adamhrnciar/hyperion-controller/fab/pcbway/hyperion-v1.2-bottom-render.png

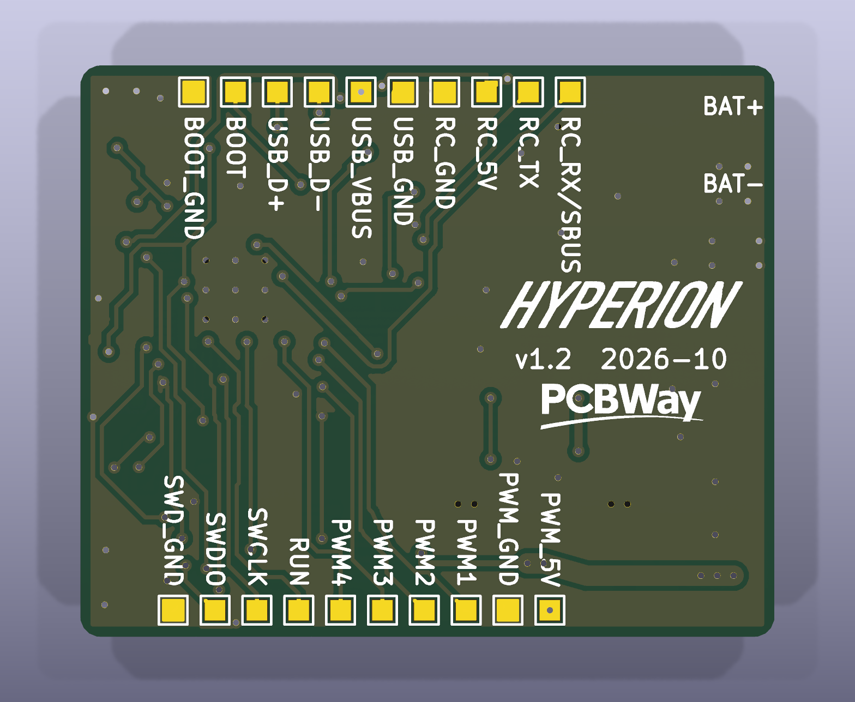
fab/pcbway/hyperion-v1.2-bottom-render.png
