adamhrnciar/hyperion-controller/images/preview_bottom.png

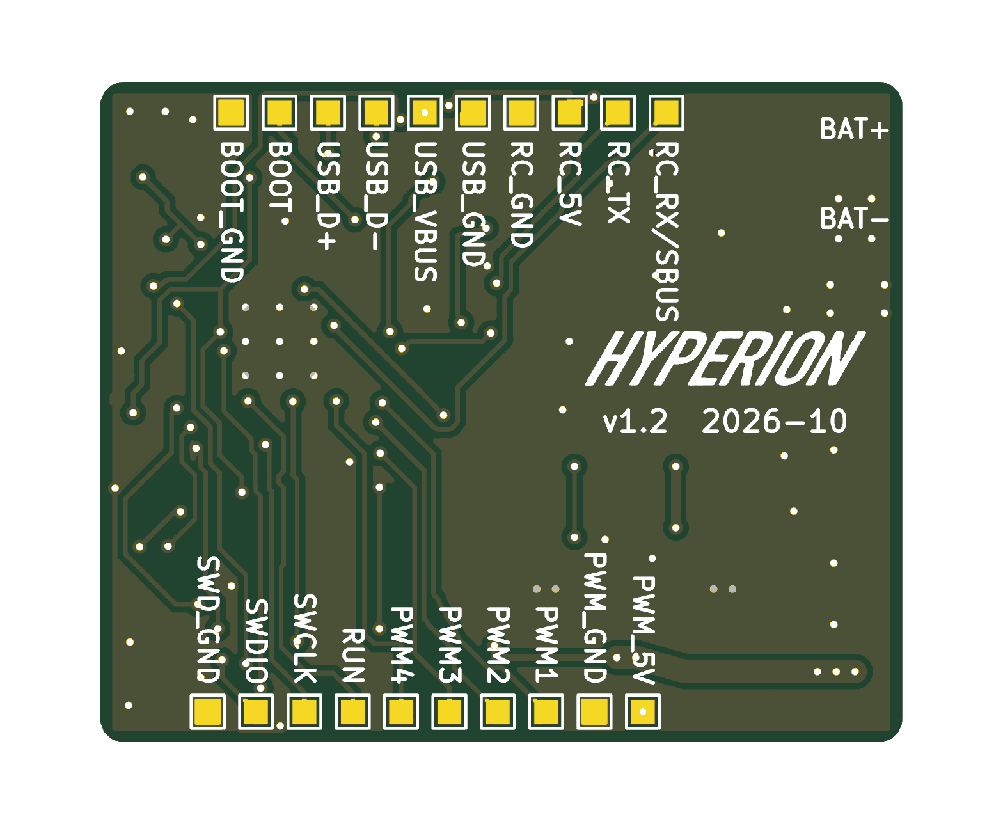
images/preview_bottom.png
