adamhrnciar/hyperion-controller/images/preview_top.png

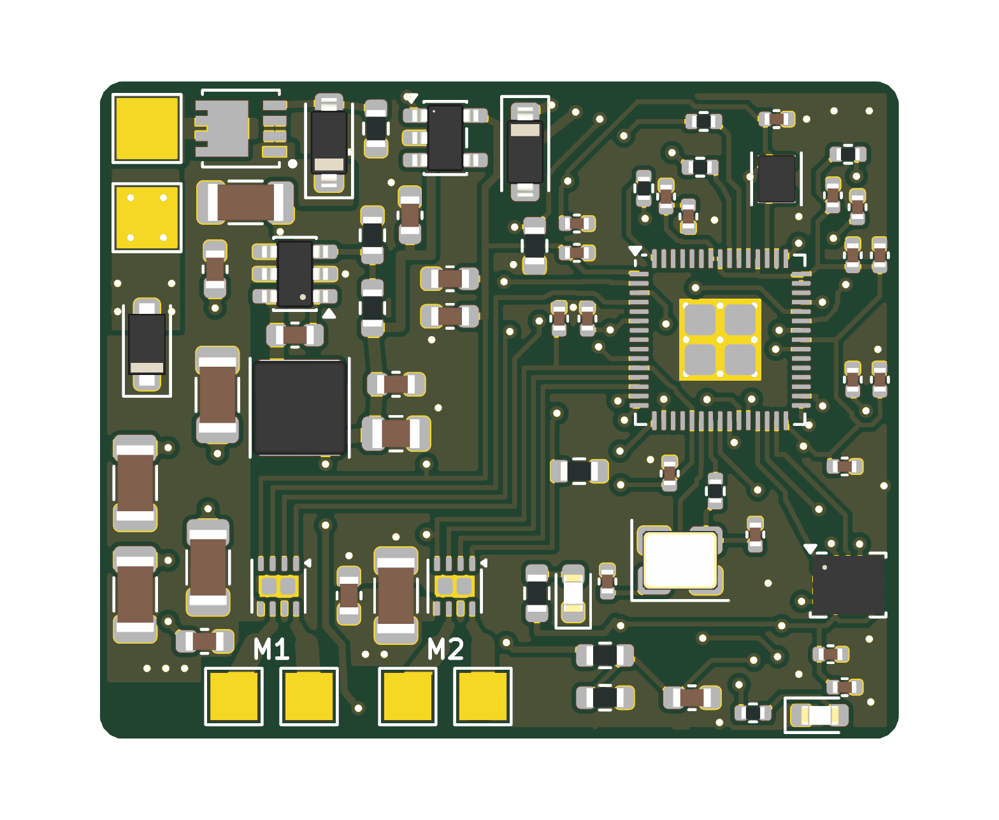
images/preview_top.png
