adamhrnciar/hyperion-controller/fab/review-2026-11-13/schematic-bom.csv

Reference | Value | Footprint | LCSC | MPN | Manufacturer | DNP | EXCLUDE_FROM_BOARD | EXCLUDE_FROM_BOM
C1 | 10uF 50V X7R | Capacitor_SMD:C_1206_3216Metric | C89632 | CL31B106KBHNNNE
C2 | 10uF 50V X7R | Capacitor_SMD:C_1206_3216Metric | C89632 | CL31B106KBHNNNE
C3 | 100uF 35V elec DNP (wire to pads) | Capacitor_SMD:C_1206_3216Metric | C2836437 | RVE100UF35V67RV0072 (optional, hand-wired)
C4 | 4.7uF 50V X7R | Capacitor_SMD:C_1206_3216Metric | C7472974 | HGC1206R7475K500NSPJ
C5 | 100nF 50V | Capacitor_SMD:C_0603_1608Metric | C286510 | 0603B104M500NT
C6 | 100nF 50V | Capacitor_SMD:C_0603_1608Metric | C286510 | 0603B104M500NT
C7 | 22uF 10V | Capacitor_SMD:C_0805_2012Metric | C29277 | CL21A226MPQNNNE
C8 | 100nF 50V | Capacitor_SMD:C_0603_1608Metric | C286510 | 0603B104M500NT
C9 | 10uF 10V | Capacitor_SMD:C_0603_1608Metric | C19702 | CL10A106KP8NNNC
C10 | 1uF 16V | Capacitor_SMD:C_0603_1608Metric | C696901 | TCC0603X5R105K160CT
C11 | 1uF 16V | Capacitor_SMD:C_0603_1608Metric | C696901 | TCC0603X5R105K160CT
C12 | 4.7uF 16V | Capacitor_SMD:C_0603_1608Metric | C19666 | CL10A475KO8NNNC
C13 | 100nF | Capacitor_SMD:C_0402_1005Metric | C1525 | CL05B104KO5NNNC
C14 | 100nF | Capacitor_SMD:C_0402_1005Metric | C1525 | CL05B104KO5NNNC
C15 | 100nF | Capacitor_SMD:C_0402_1005Metric | C1525 | CL05B104KO5NNNC
C16 | 100nF | Capacitor_SMD:C_0402_1005Metric | C1525 | CL05B104KO5NNNC
C17 | 100nF | Capacitor_SMD:C_0402_1005Metric | C1525 | CL05B104KO5NNNC
C18 | 100nF | Capacitor_SMD:C_0402_1005Metric | C1525 | CL05B104KO5NNNC
C19 | 100nF | Capacitor_SMD:C_0402_1005Metric | C1525 | CL05B104KO5NNNC
C20 | 100nF | Capacitor_SMD:C_0402_1005Metric | C1525 | CL05B104KO5NNNC
C21 | 100nF | Capacitor_SMD:C_0402_1005Metric | C1525 | CL05B104KO5NNNC
C22 | 4.7uF 10V | Capacitor_SMD:C_0402_1005Metric | C23733 | CL05A475MP5NRNC
C23 | 4.7uF 10V | Capacitor_SMD:C_0402_1005Metric | C23733 | CL05A475MP5NRNC
C24 | 4.7uF 10V | Capacitor_SMD:C_0402_1005Metric | C23733 | CL05A475MP5NRNC
C25 | 100nF | Capacitor_SMD:C_0402_1005Metric | C1525 | CL05B104KO5NNNC
C26 | 100nF | Capacitor_SMD:C_0402_1005Metric | C1525 | CL05B104KO5NNNC
C27 | 100nF | Capacitor_SMD:C_0402_1005Metric | C1525 | CL05B104KO5NNNC
C28 | 15pF | Capacitor_SMD:C_0402_1005Metric | C1548 | 0402CG150J500NT
C29 | 15pF | Capacitor_SMD:C_0402_1005Metric | C1548 | 0402CG150J500NT
C30 | 100nF 50V | Capacitor_SMD:C_0603_1608Metric | C286510 | 0603B104M500NT
C31 | 10uF 50V X7R | Capacitor_SMD:C_1206_3216Metric | C89632 | CL31B106KBHNNNE
C32 | 100nF 50V | Capacitor_SMD:C_0603_1608Metric | C286510 | 0603B104M500NT
C33 | 10uF 50V X7R | Capacitor_SMD:C_1206_3216Metric | C89632 | CL31B106KBHNNNE
C34 | 100nF | Capacitor_SMD:C_0402_1005Metric | C1525 | CL05B104KO5NNNC
C35 | 100nF | Capacitor_SMD:C_0402_1005Metric | C1525 | CL05B104KO5NNNC
D1 | SMF18A | Diode_SMD:D_SOD-123F | C1509591 | SMF18A (JSCJ)
D2 | BZT52C12 | Diode_SMD:D_SOD-123 | C173429 | BZT52C12 (MDD)
D3 | B5819W | Diode_SMD:D_SOD-123 | C64885 | B5819W (MDD)
D4 | Red | LED_SMD:LED_0603_1608Metric | C2286 | KT-0603R
D5 | Green | LED_SMD:LED_0603_1608Metric | C7496818 | P2-0603G1TS2-06T-002
L1 | 3.3uH AOTA-B201610S3R3-101-T | Inductor_SMD:L_Murata_DFE201610P | C42411119 | AOTA-B201610S3R3-101-T
L2 | 10uH FNR4030S100MT | Inductor_SMD:L_Changjiang_FNR4030S | C167879 | FNR4030S100MT
Q1 | AON7403 | hyperion:AON7403_PowerPAK1212-8_GSD | C5310961 | AON7403 (TECH PUBLIC)
R1 | 47k | Resistor_SMD:R_0603_1608Metric | C25819 | 0603WAF4702T5E
R2 | 115k 1% | Resistor_SMD:R_0603_1608Metric | C22783 | 0603WAF1153T5E
R3 | 22k 1% | Resistor_SMD:R_0603_1608Metric | C31850 | 0603WAF2202T5E
R4 | 100k | Resistor_SMD:R_0603_1608Metric | C25803 | 0603WAF1003T5E
R5 | 22k | Resistor_SMD:R_0603_1608Metric | C31850 | 0603WAF2202T5E
R6 | 1k | Resistor_SMD:R_0603_1608Metric | C21190 | 0603WAF1001T5E
R7 | 33R | Resistor_SMD:R_0402_1005Metric | C25105 | 0402WGF330JTCE
R8 | 1k | Resistor_SMD:R_0402_1005Metric | C11702 | 0402WGF1001TCE
R9 | 27R | Resistor_SMD:R_0402_1005Metric | C140174 | RC-02K27R0FT
R10 | 27R | Resistor_SMD:R_0402_1005Metric | C140174 | RC-02K27R0FT
R11 | 1k | Resistor_SMD:R_0402_1005Metric | C11702 | 0402WGF1001TCE
R12 | 1k | Resistor_SMD:R_0402_1005Metric | C11702 | 0402WGF1001TCE
R13 | 1.5k 1% | Resistor_SMD:R_0603_1608Metric | C22843 | 0603WAF1501T5E
R14 | 1.5k 1% | Resistor_SMD:R_0603_1608Metric | C22843 | 0603WAF1501T5E
TP1 | BAT+ | TestPoint:TestPoint_Pad_2.5x2.5mm
TP2 | BAT- | TestPoint:TestPoint_Pad_2.5x2.5mm
TP3 | USB_VBUS | TestPoint:TestPoint_Pad_1.0x1.0mm
TP4 | USB_D+ | TestPoint:TestPoint_Pad_1.0x1.0mm
TP5 | USB_D- | TestPoint:TestPoint_Pad_1.0x1.0mm
TP6 | USB_GND | TestPoint:TestPoint_Pad_1.0x1.0mm
TP7 | RUN | TestPoint:TestPoint_Pad_1.0x1.0mm
TP8 | SWCLK | TestPoint:TestPoint_Pad_1.0x1.0mm
TP9 | SWDIO | TestPoint:TestPoint_Pad_1.0x1.0mm
TP10 | SWD_GND | TestPoint:TestPoint_Pad_1.0x1.0mm
TP11 | BOOT | TestPoint:TestPoint_Pad_1.0x1.0mm
TP12 | BOOT_GND | TestPoint:TestPoint_Pad_1.0x1.0mm
TP13 | M1A | TestPoint:TestPoint_Pad_2.0x2.0mm
TP14 | M1B | TestPoint:TestPoint_Pad_2.0x2.0mm
TP15 | M2A | TestPoint:TestPoint_Pad_2.0x2.0mm
TP16 | M2B | TestPoint:TestPoint_Pad_2.0x2.0mm
TP17 | RC_5V | TestPoint:TestPoint_Pad_1.0x1.0mm
TP18 | RC_GND | TestPoint:TestPoint_Pad_1.0x1.0mm
TP19 | RC_TX | TestPoint:TestPoint_Pad_1.0x1.0mm
TP20 | RC_RX/SBUS | TestPoint:TestPoint_Pad_1.0x1.0mm
TP21 | PWM1 | TestPoint:TestPoint_Pad_1.0x1.0mm
TP22 | PWM2 | TestPoint:TestPoint_Pad_1.0x1.0mm
TP23 | PWM3 | TestPoint:TestPoint_Pad_1.0x1.0mm
TP24 | PWM4 | TestPoint:TestPoint_Pad_1.0x1.0mm
TP25 | PWM_5V | TestPoint:TestPoint_Pad_1.0x1.0mm
TP26 | PWM_GND | TestPoint:TestPoint_Pad_1.0x1.0mm
U1 | RP2354A | hyperion:RP2354A_QFN-60_CircuitNinja | C41378174 | RP2354A
U2 | DRV8231ADSGR | Package_SON:Texas_DSG0008A_WSON-8-1EP_2x2mm_P0.5mm_EP0.9x1.6mm | C5139865 | DRV8231ADSGR
U3 | DRV8231ADSGR | Package_SON:Texas_DSG0008A_WSON-8-1EP_2x2mm_P0.5mm_EP0.9x1.6mm | C5139865 | DRV8231ADSGR
U4 | LMR51610YDBVR | Package_TO_SOT_SMD:SOT-23-6 | C22427220 | LMR51610YDBVR
U5 | ME6211C33M5G | Package_TO_SOT_SMD:SOT-23-5 | C82942 | ME6211C33M5G-N
U6 | LSM6DSV32XTR | hyperion:LGA-14_3x2.5mm_P0.5mm_CircuitNinja | C22461202 | LSM6DSV32XTR
Y1 | 12MHz ABM8-272-T3 | Crystal:Crystal_SMD_3225-4Pin_3.2x2.5mm | C20625731 | ABM8-272-T3
