adamhrnciar/hyperion-controller/docs/hyperion-v1.2-schematic.pdf

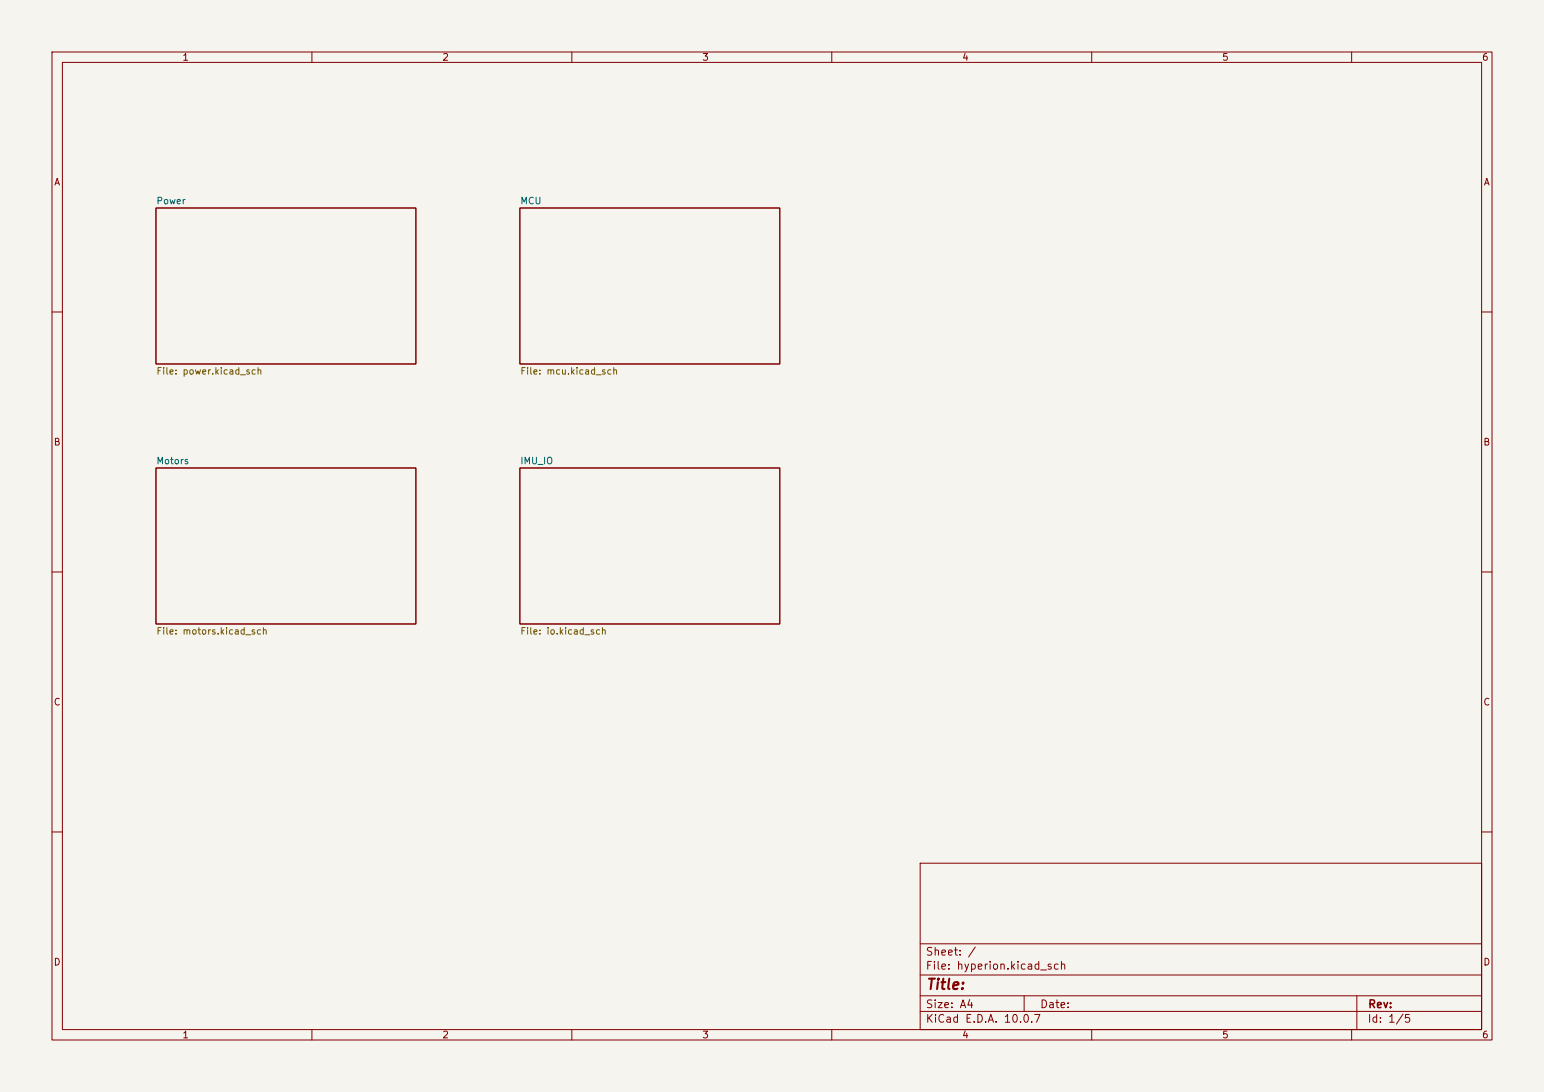
[picture p6: page 1]

File: mcu.kicad_sch Motors File: motors.kicad_sch

Size: A4 | Rev:
KiCad E.D.A. 10.0.7 | Id: 1/5

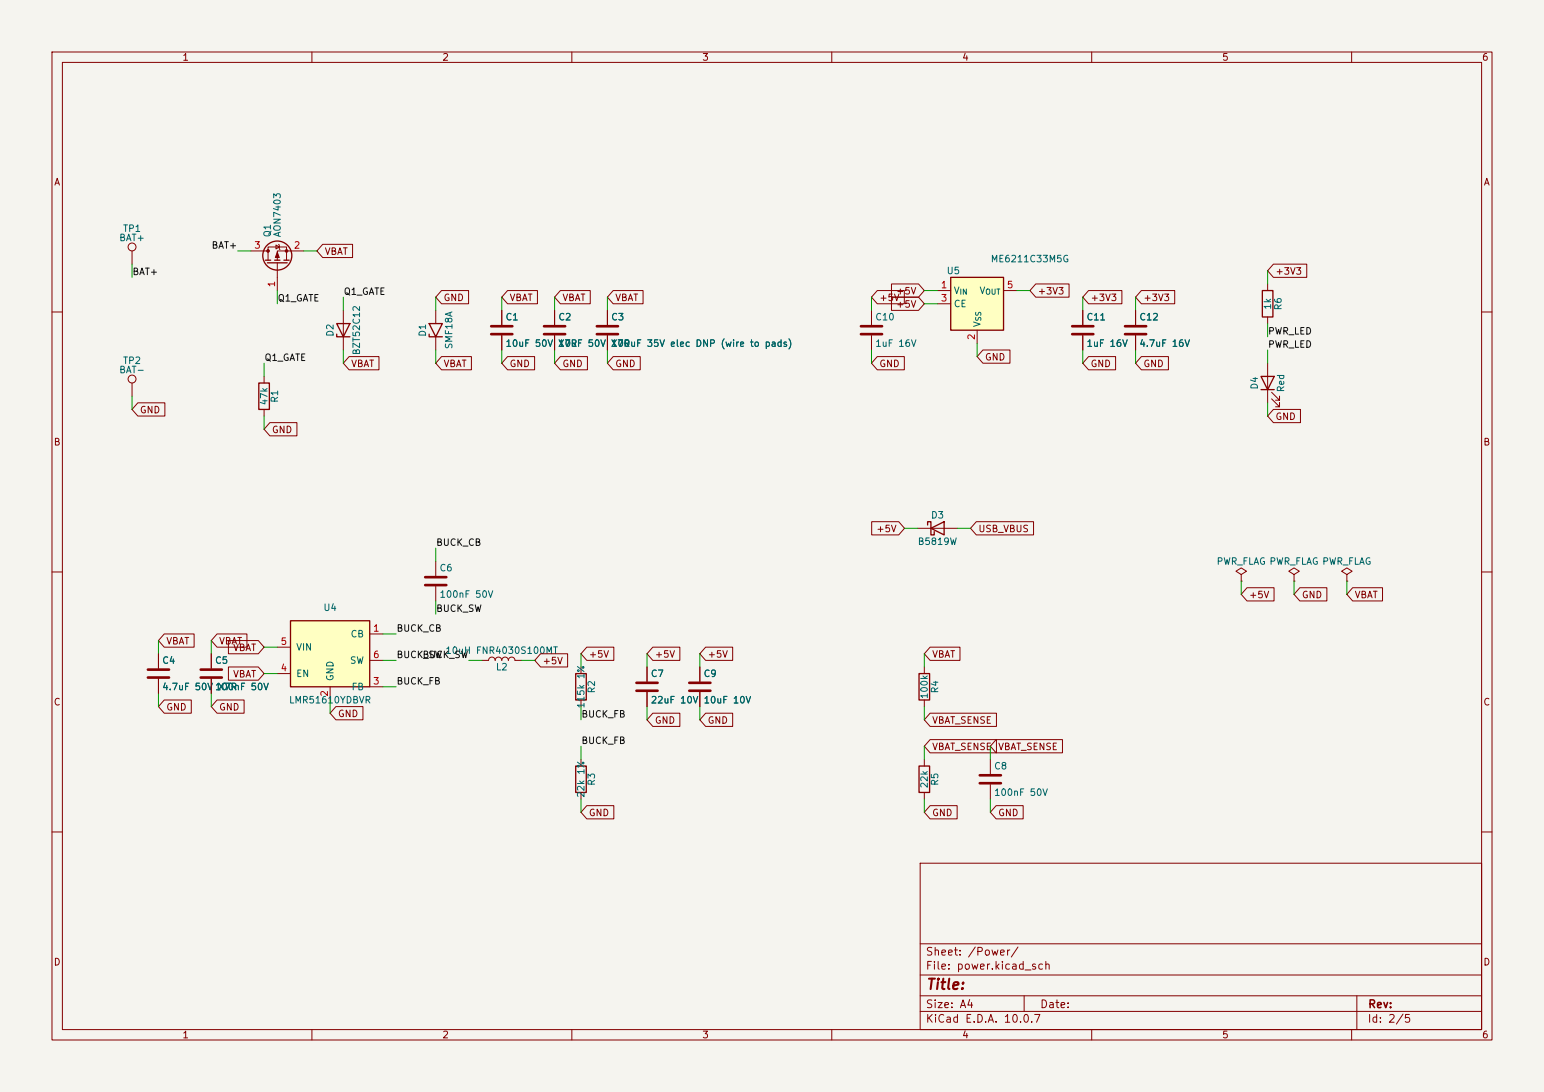
[picture p7: page 2]

100uF 35V elec DNP (wire to pads) C9

100uF 35V elec DNP (wire to pads) C7

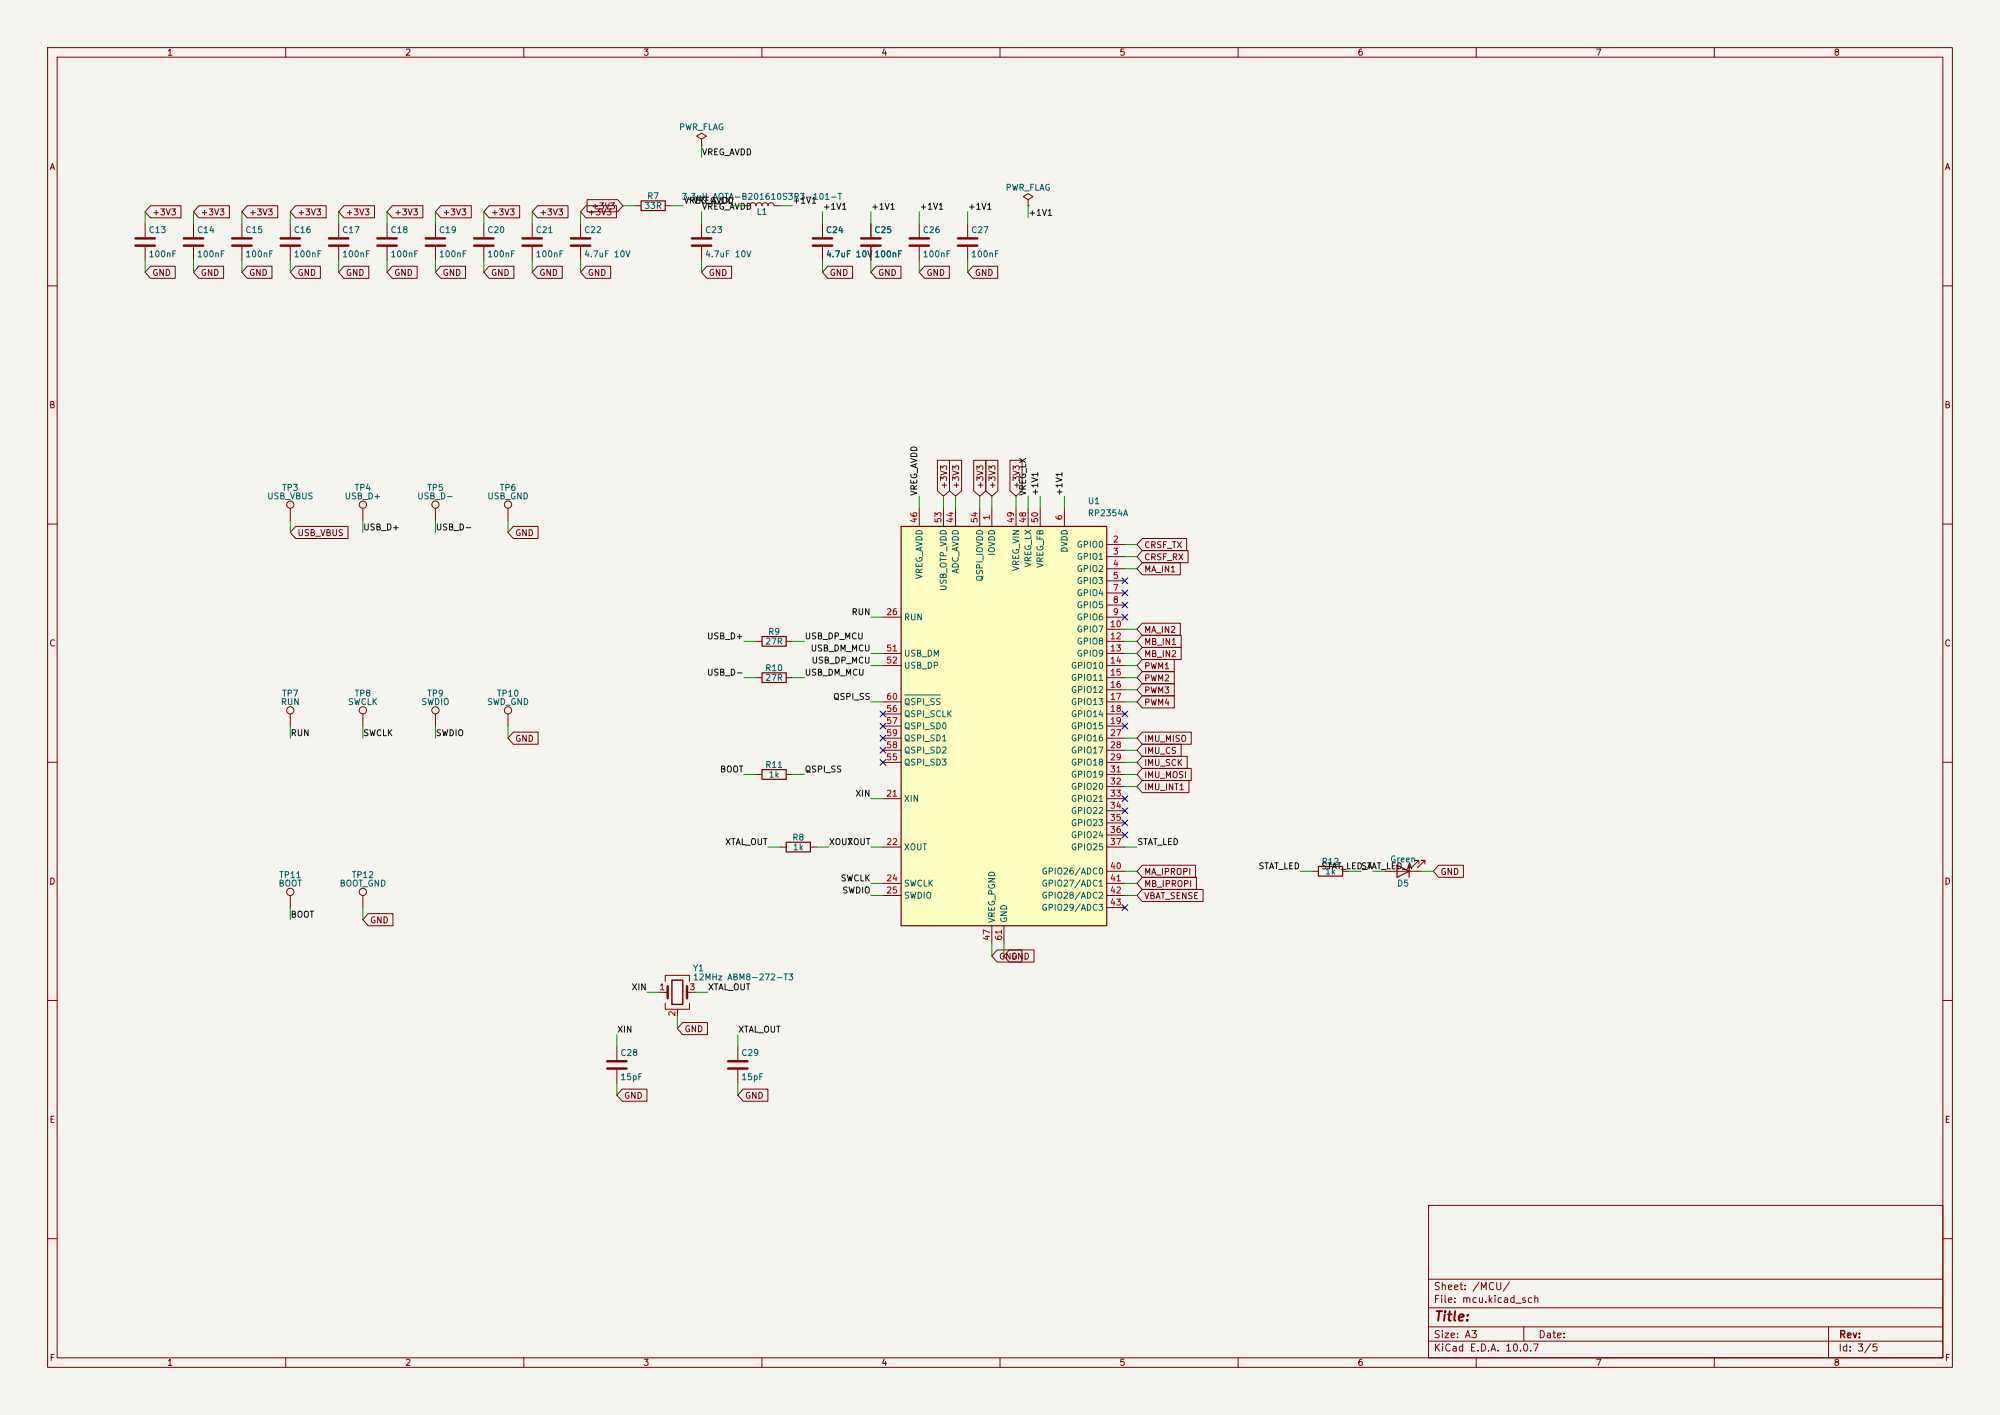
[picture p8: page 3]

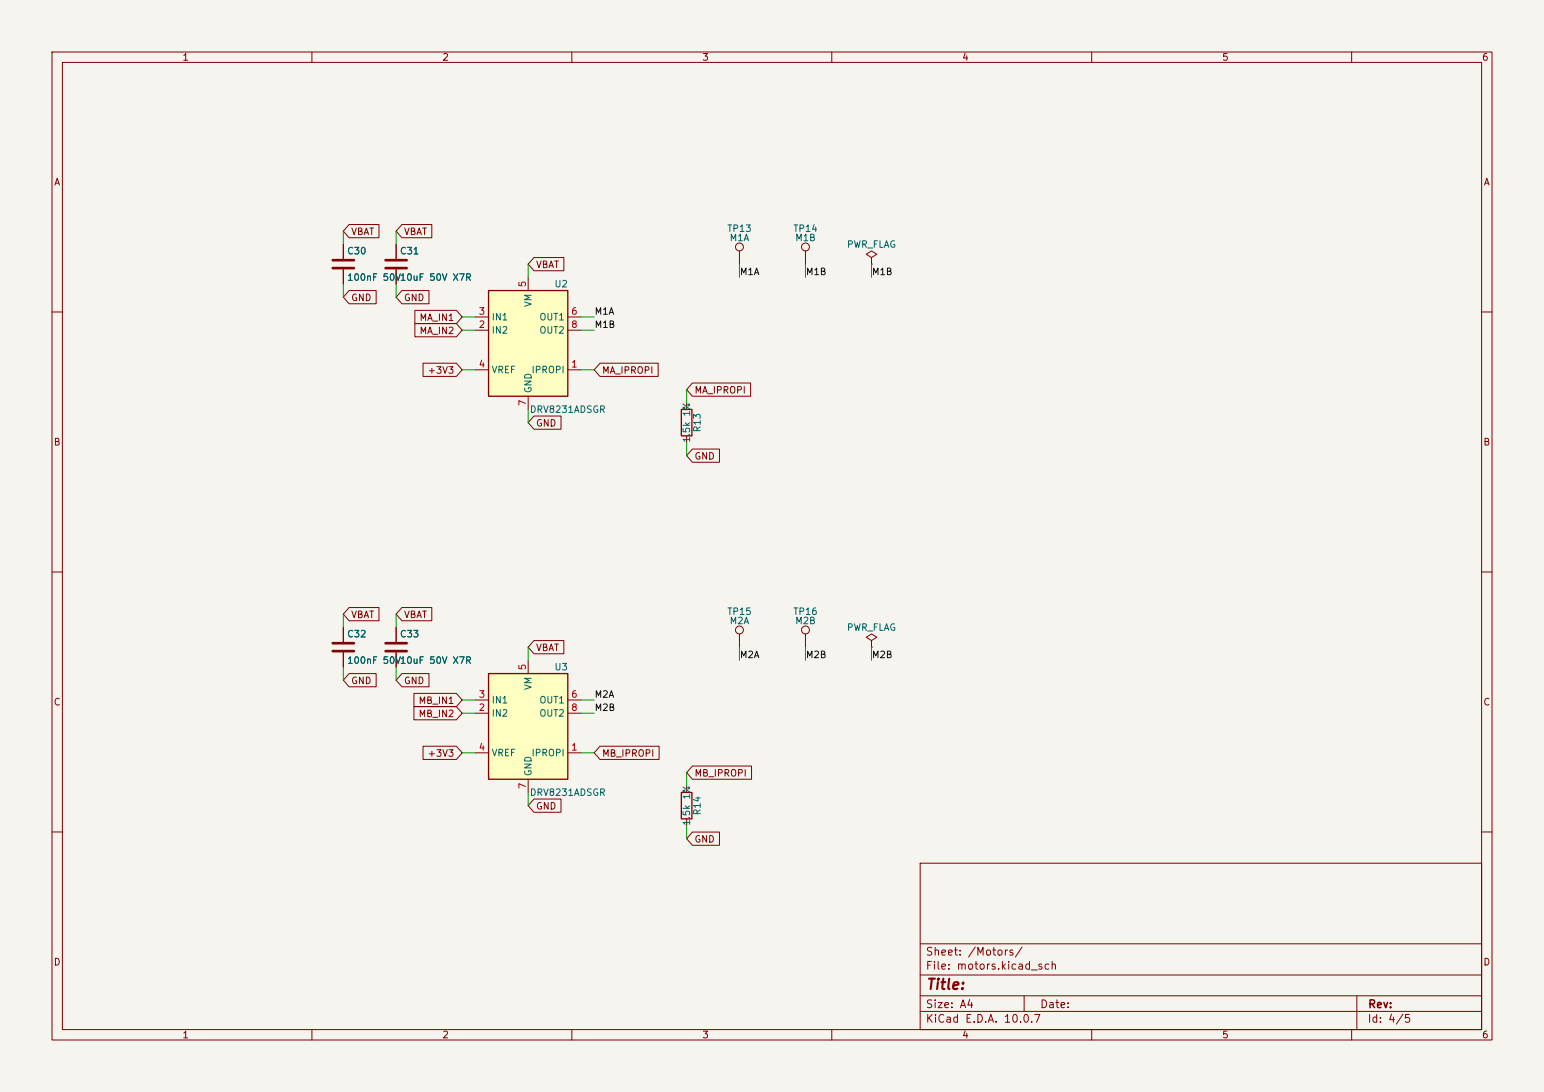
[picture p9: page 4]

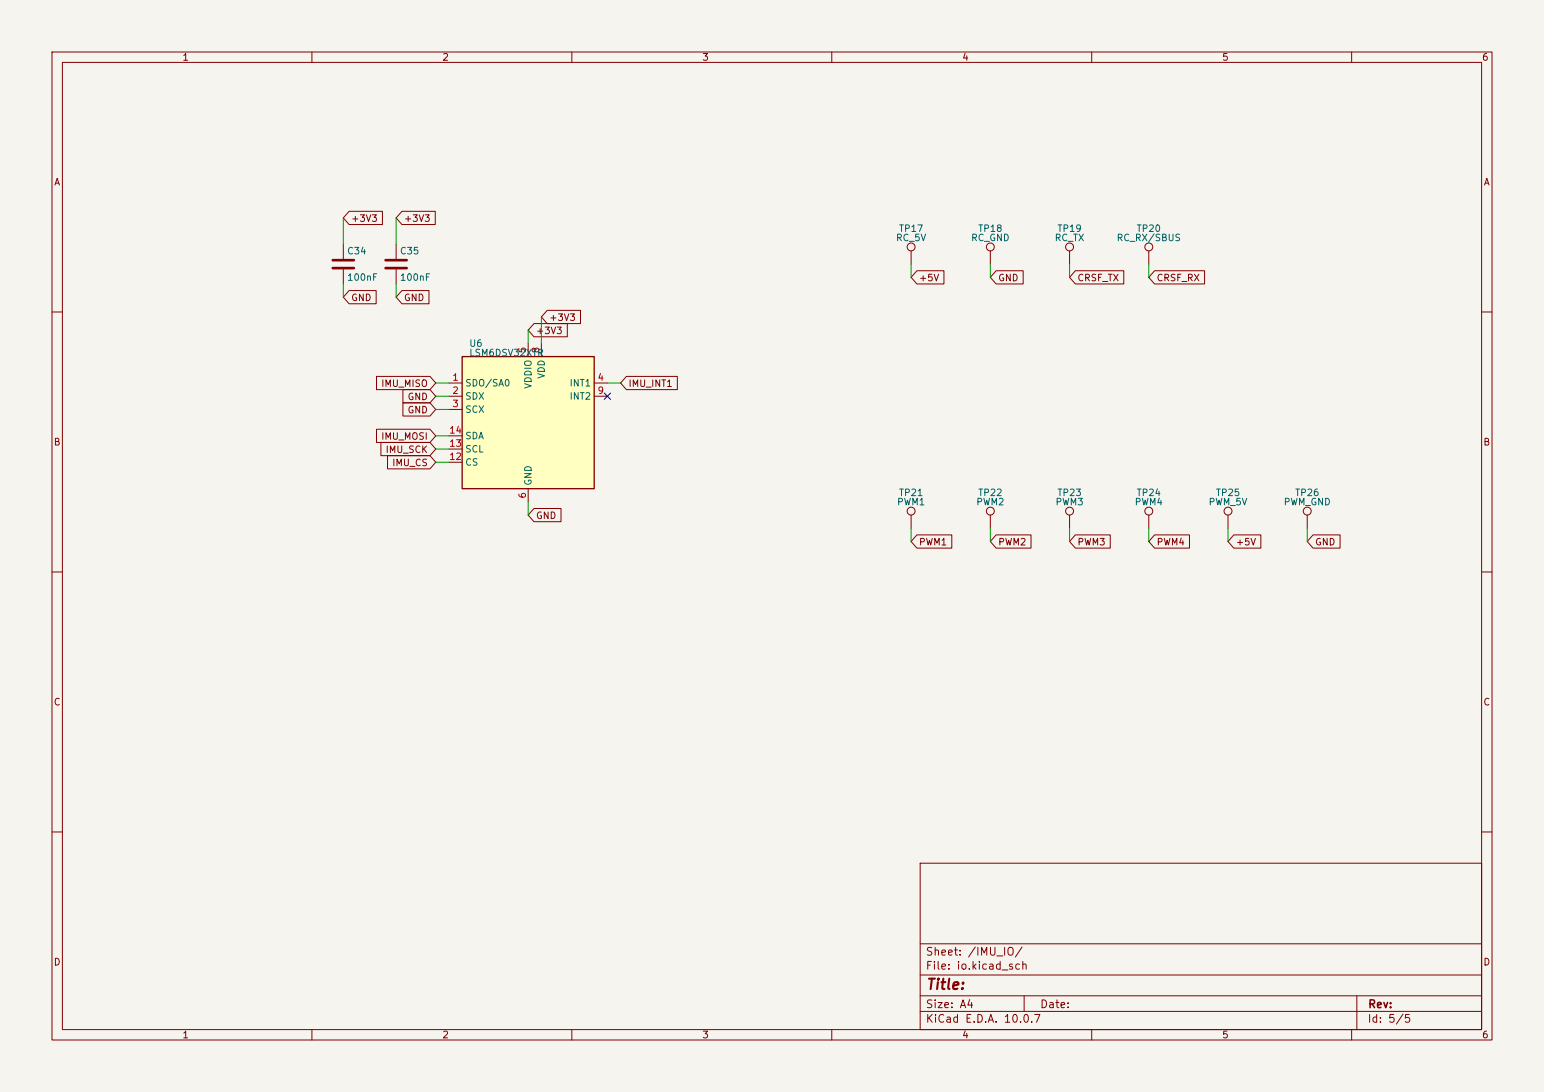
[picture p10: page 5]
