adamhrnciar/hyperion-controller/hardware/hyperion.kicad_pcb

## KiCad design hardware/hyperion.kicad_pcb (2026-11-13)

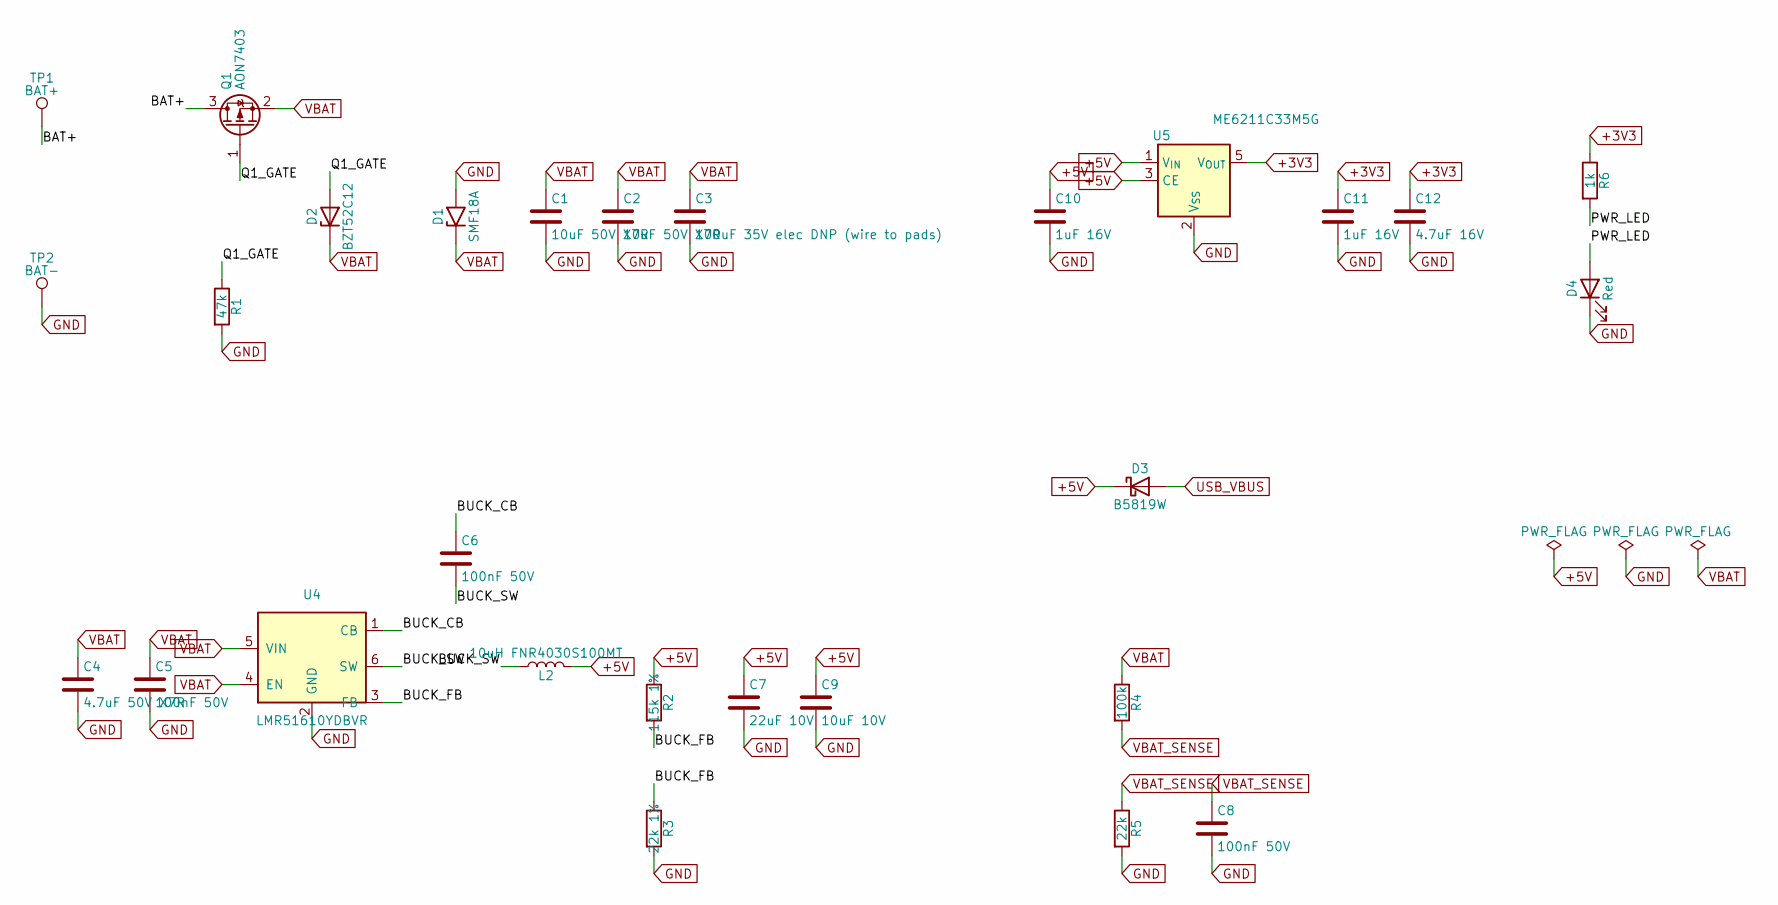
[picture p11: schematic power.kicad_sch]

Parts:
C1, C2: 10uF 50V X7R; C_1206_3216Metric; MPN CL31B106KBHNNNE; LCSC C89632
C3: 100uF 35V elec DNP (wire to pads); C_1206_3216Metric; MPN RVE100UF35V67RV0072 (optional, hand-wir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; LCSC C2836437
C4: 4.7uF 50V X7R; C_1206_3216Metric; MPN HGC1206R7475K500NSPJ; LCSC C7472974
C5, C6, C8: 100nF 50V; C_0603_1608Metric; MPN 0603B104M500NT; LCSC C286510
C7: 22uF 10V; C_0805_2012Metric; MPN CL21A226MPQNNNE; LCSC C29277
C9: 10uF 10V; C_0603_1608Metric; MPN CL10A106KP8NNNC; LCSC C19702
C10, C11: 1uF 16V; C_0603_1608Metric; MPN TCC0603X5R105K160CT; LCSC C696901
C12: 4.7uF 16V; C_0603_1608Metric; MPN CL10A475KO8NNNC; LCSC C19666
D1: SMF18A; D_SOD-123F; MPN SMF18A (JSCJ); LCSC C1509591
D2: BZT52C12; D_SOD-123; MPN BZT52C12 (MDD); LCSC C173429
D3: B5819W; D_SOD-123; MPN B5819W (MDD); LCSC C64885
D4: Red; LED_0603_1608Metric; MPN KT-0603R; LCSC C2286
L2: 10uH FNR4030S100MT; L_Changjiang_FNR4030S; MPN FNR4030S100MT; LCSC C167879
Q1: AON7403; AON7403_PowerPAK1212-8_GSD; MPN AON7403 (TECH PUBLIC); LCSC C5310961
R1: 47k; R_0603_1608Metric; MPN 0603WAF4702T5E; LCSC C25819
R2: 115k 1%; R_0603_1608Metric; MPN 0603WAF1153T5E; LCSC C22783
R3: 22k 1%; R_0603_1608Metric; MPN 0603WAF2202T5E; LCSC C31850
R4: 100k; R_0603_1608Metric; MPN 0603WAF1003T5E; LCSC C25803
R5: 22k; R_0603_1608Metric; MPN 0603WAF2202T5E; LCSC C31850
R6: 1k; R_0603_1608Metric; MPN 0603WAF1001T5E; LCSC C21190
TP1: BAT+; TestPoint_Pad_2.5x2.5mm
TP2: BAT-; TestPoint_Pad_2.5x2.5mm
U4: LMR51610YDBVR; SOT-23-6; MPN LMR51610YDBVR; LCSC C22427220
U5: ME6211C33M5G; SOT-23-5; MPN ME6211C33M5G-N; LCSC C82942

Connections:
+3V3: C11.1, C12.1, R6.1, U5.5 (V_{OUT}); also elsewhere on the board
+5V: C7.1, C9.1, C10.1, D3.1 (K), L2.2, R2.1, U5.1 (V_{IN}), U5.3 (CE); also elsewhere on the board
/Power/BAT+: Q1.3 (D), TP1.1 (1_1)
/Power/BUCK_CB: C6.1, U4.1 (CB)
/Power/BUCK_FB: R2.2, R3.1, U4.3 (FB)
/Power/BUCK_SW: C6.2, L2.1, U4.6 (SW)
/Power/PWR_LED: D4.2 (A), R6.2
/Power/Q1_GATE: D2.2 (A), Q1.1 (G), R1.1
GND: C1.2, C2.2, C3.2, C4.2, C5.2, C7.2, C8.2, C9.2, C10.2, C11.2, C12.2, D1.2 (A2), D4.1 (K), R1.2, R3.2, R5.2, TP2.1 (1_1), U4.2 (GND), U5.2 (V_{SS}); also elsewhere on the board
USB_VBUS: D3.2 (A); also elsewhere on the board
VBAT: C1.1, C2.1, C3.1, C4.1, C5.1, D1.1 (A1), D2.1 (K), Q1.2 (S), R4.1, U4.4 (EN), U4.5 (VIN); also elsewhere on the board
VBAT_SENSE: C8.1, R4.2, R5.1; also elsewhere on the board

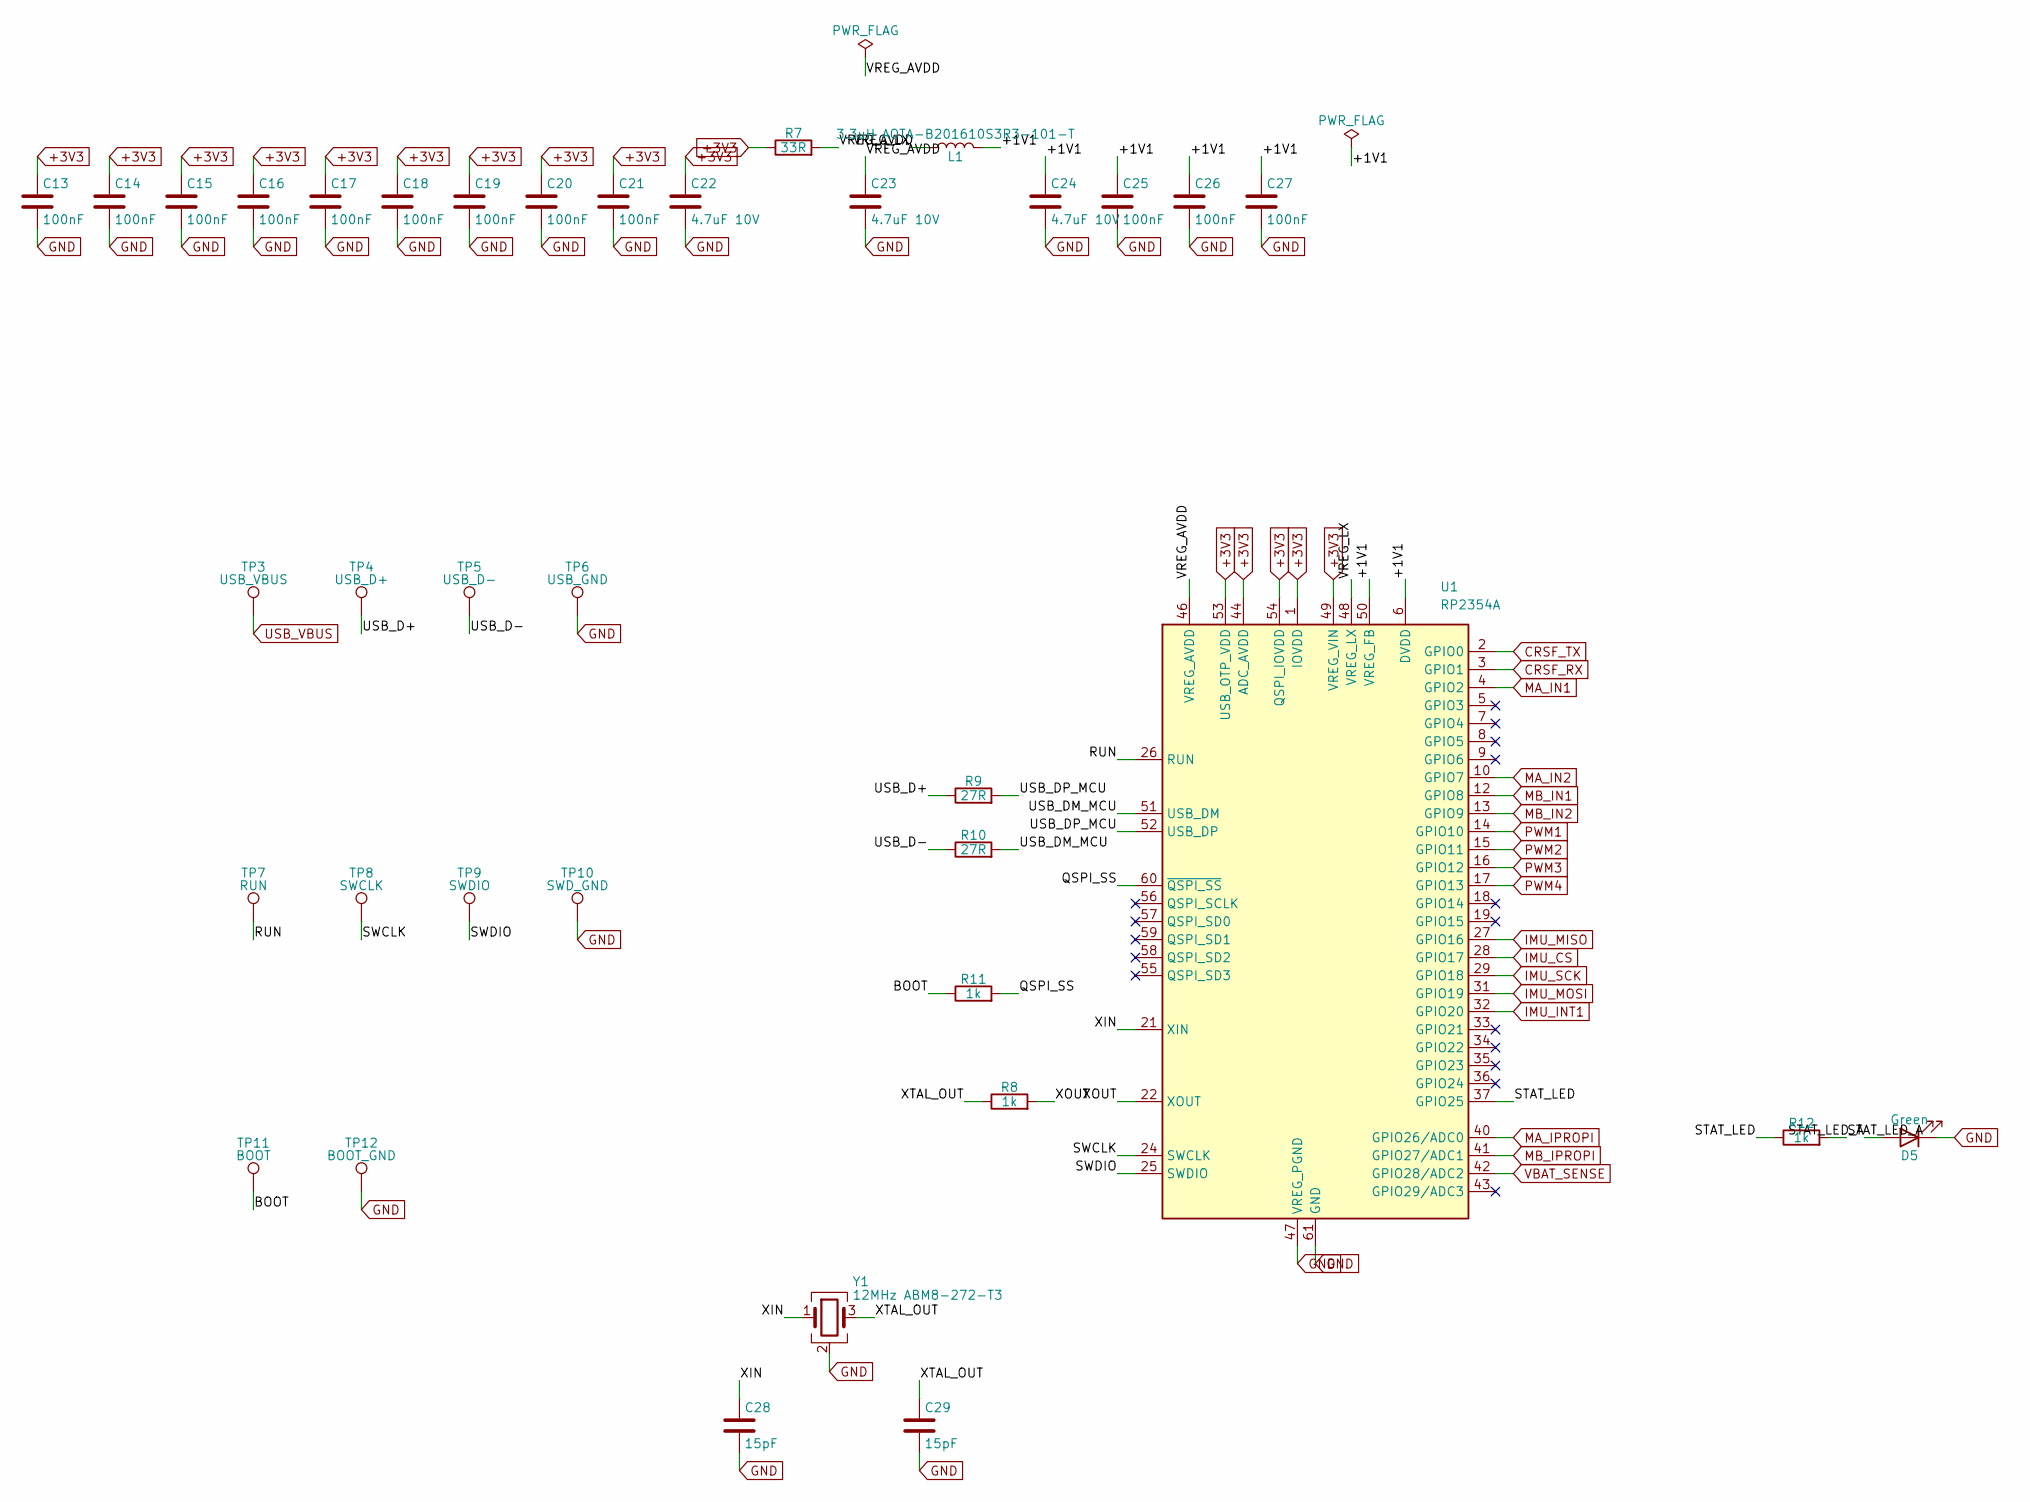
[picture p12: schematic mcu.kicad_sch]

Parts:
C13, C14, C15, C16, C17, C18, C19, C20, C21, C25, C26, C27: 100nF; C_0402_1005Metric; MPN CL05B104KO5NNNC; LCSC C1525
C22, C23, C24: 4.7uF 10V; C_0402_1005Metric; MPN CL05A475MP5NRNC; LCSC C23733
C28, C29: 15pF; C_0402_1005Metric; MPN 0402CG150J500NT; LCSC C1548
D5: Green; LED_0603_1608Metric; MPN P2-0603G1TS2-06T-002; LCSC C7496818
L1: 3.3uH AOTA-B201610S3R3-101-T; L_Murata_DFE201610P; MPN AOTA-B201610S3R3-101-T; LCSC C42411119
R7: 33R; R_0402_1005Metric; MPN 0402WGF330JTCE; LCSC C25105
R8, R11, R12: 1k; R_0402_1005Metric; MPN 0402WGF1001TCE; LCSC C11702
R9, R10: 27R; R_0402_1005Metric; MPN RC-02K27R0FT; LCSC C140174
TP3: USB_VBUS; TestPoint_Pad_1.0x1.0mm
TP4: USB_D+; TestPoint_Pad_1.0x1.0mm
TP5: USB_D-; TestPoint_Pad_1.0x1.0mm
TP6: USB_GND; TestPoint_Pad_1.0x1.0mm
TP7: RUN; TestPoint_Pad_1.0x1.0mm
TP8: SWCLK; TestPoint_Pad_1.0x1.0mm
TP9: SWDIO; TestPoint_Pad_1.0x1.0mm
TP10: SWD_GND; TestPoint_Pad_1.0x1.0mm
TP11: BOOT; TestPoint_Pad_1.0x1.0mm
TP12: BOOT_GND; TestPoint_Pad_1.0x1.0mm
U1: RP2354A; RP2354A_QFN-60_CircuitNinja; MPN RP2354A; LCSC C41378174
Y1: 12MHz ABM8-272-T3; Crystal_SMD_3225-4Pin_3.2x2.5mm; MPN ABM8-272-T3; LCSC C20625731

Connections:
+3V3: C13.1, C14.1, C15.1, C16.1, C17.1, C18.1, C19.1, C20.1, C21.1, C22.1, R7.1, U1.1 (IOVDD), U1.11 (IOVDD), U1.20 (IOVDD), U1.30 (IOVDD), U1.38 (IOVDD), U1.44 (ADC_AVDD), U1.45 (IOVDD), U1.49 (VREG_VIN), U1.53 (USB_OTP_VDD), U1.54 (QSPI_IOVDD); also elsewhere on the board
/MCU/+1V1: C24.1, C25.1, C26.1, C27.1, L1.2, U1.6 (DVDD), U1.23 (DVDD), U1.39 (DVDD), U1.50 (VREG_FB)
/MCU/BOOT: R11.1, TP11.1 (1_1)
/MCU/QSPI_SS: R11.2, U1.60 (~QSPI_SS)
/MCU/RUN: TP7.1 (1_1), U1.26 (RUN)
/MCU/STAT_LED: R12.1, U1.37 (GPIO25)
/MCU/STAT_LED_A: D5.2 (A), R12.2
/MCU/SWCLK: TP8.1 (1_1), U1.24 (SWCLK)
/MCU/SWDIO: TP9.1 (1_1), U1.25 (SWDIO)
/MCU/USB_D+: R9.1, TP4.1 (1_1)
/MCU/USB_D-: R10.1, TP5.1 (1_1)
/MCU/USB_DM_MCU: R10.2, U1.51 (USB_DM)
/MCU/USB_DP_MCU: R9.2, U1.52 (USB_DP)
/MCU/VREG_AVDD: C23.1, R7.2, U1.46 (VREG_AVDD)
/MCU/VREG_LX: L1.1, U1.48 (VREG_LX)
/MCU/XIN: C28.1, U1.21 (XIN), Y1.1
/MCU/XOUT: R8.2, U1.22 (XOUT)
/MCU/XTAL_OUT: C29.1, R8.1, Y1.3
CRSF_RX: U1.3 (GPIO1); also elsewhere on the board
CRSF_TX: U1.2 (GPIO0); also elsewhere on the board
GND: C13.2, C14.2, C15.2, C16.2, C17.2, C18.2, C19.2, C20.2, C21.2, C22.2, C23.2, C24.2, C25.2, C26.2, C27.2, C28.2, C29.2, D5.1 (K), TP6.1 (1_1), TP10.1 (1_1), TP12.1 (1_1), U1.47 (VREG_PGND), U1.61 (GND), Y1.2 (G), Y1.4 (G); also elsewhere on the board
IMU_CS: U1.28 (GPIO17); also elsewhere on the board
IMU_INT1: U1.32 (GPIO20); also elsewhere on the board
IMU_MISO: U1.27 (GPIO16); also elsewhere on the board
IMU_MOSI: U1.31 (GPIO19); also elsewhere on the board
IMU_SCK: U1.29 (GPIO18); also elsewhere on the board
MA_IN1: U1.4 (GPIO2); also elsewhere on the board
MA_IN2: U1.10 (GPIO7); also elsewhere on the board
MA_IPROPI: U1.40 (GPIO26/ADC0); also elsewhere on the board
MB_IN1: U1.12 (GPIO8); also elsewhere on the board
MB_IN2: U1.13 (GPIO9); also elsewhere on the board
MB_IPROPI: U1.41 (GPIO27/ADC1); also elsewhere on the board
PWM1: U1.14 (GPIO10); also elsewhere on the board
PWM2: U1.15 (GPIO11); also elsewhere on the board
PWM3: U1.16 (GPIO12); also elsewhere on the board
PWM4: U1.17 (GPIO13); also elsewhere on the board
USB_VBUS: TP3.1 (1_1); also elsewhere on the board
VBAT_SENSE: U1.42 (GPIO28/ADC2); also elsewhere on the board

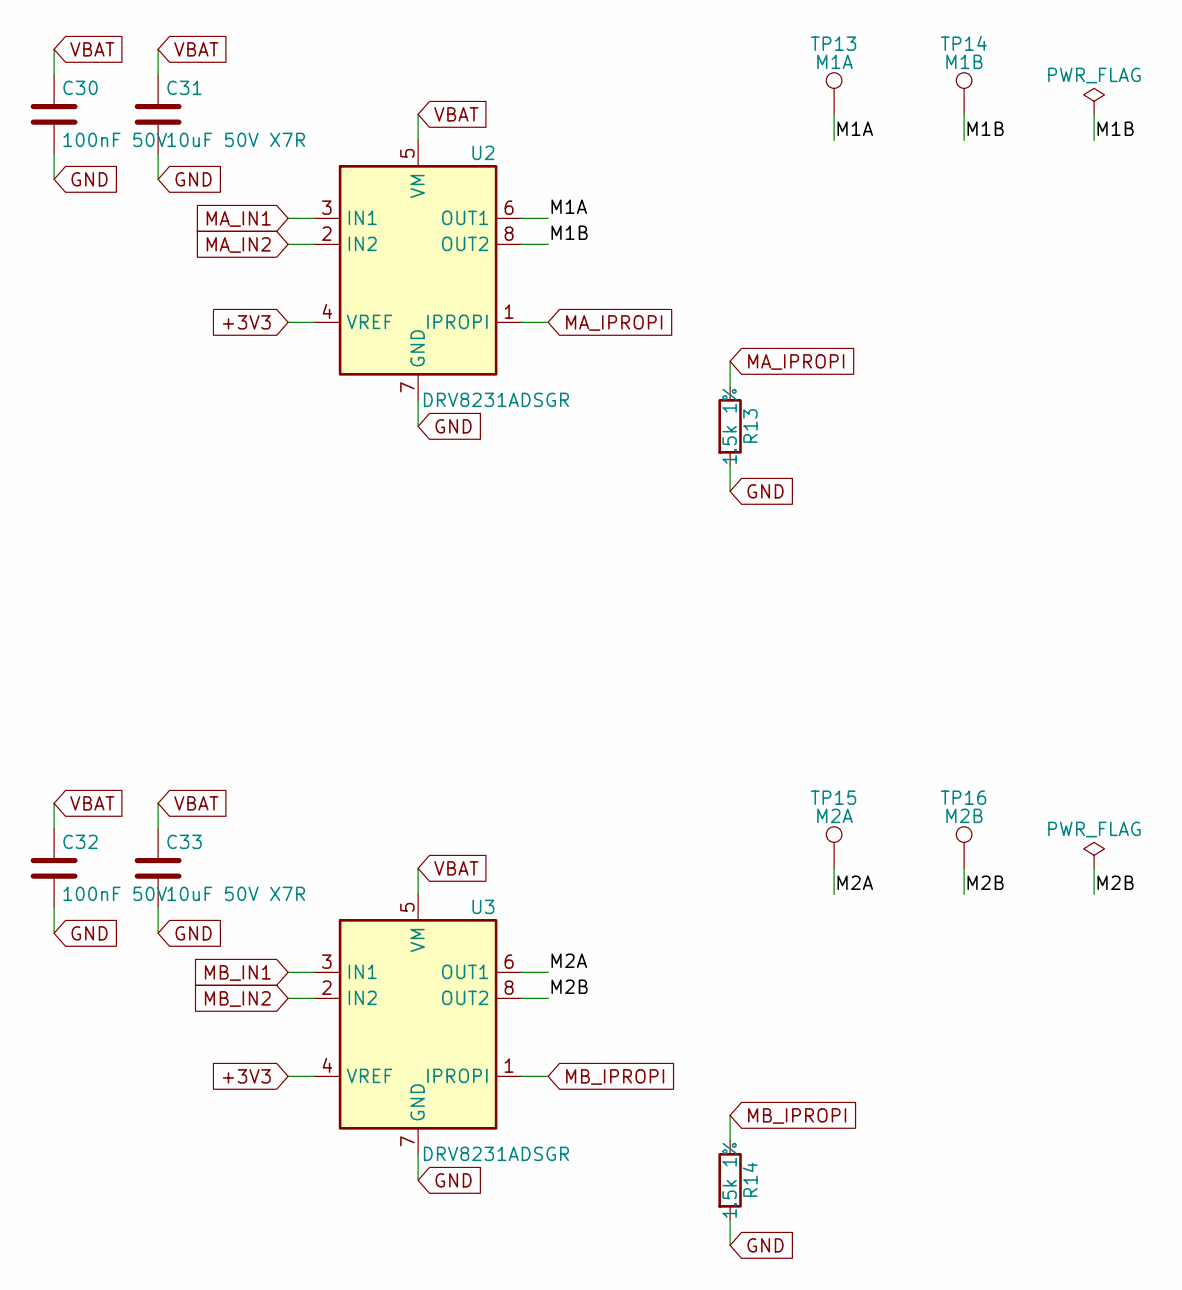
[picture p13: schematic motors.kicad_sch]

Parts:
C30, C32: 100nF 50V; C_0603_1608Metric; MPN 0603B104M500NT; LCSC C286510
C31, C33: 10uF 50V X7R; C_1206_3216Metric; MPN CL31B106KBHNNNE; LCSC C89632
R13, R14: 1.5k 1%; R_0603_1608Metric; MPN 0603WAF1501T5E; LCSC C22843
TP13: M1A; TestPoint_Pad_2.0x2.0mm
TP14: M1B; TestPoint_Pad_2.0x2.0mm
TP15: M2A; TestPoint_Pad_2.0x2.0mm
TP16: M2B; TestPoint_Pad_2.0x2.0mm
U2, U3: DRV8231ADSGR; Texas_DSG0008A_WSON-8-1EP_2x2mm_P0.5mm_EP0.9x1.6mm; MPN DRV8231ADSGR; LCSC C5139865

Connections:
+3V3: U2.4 (VREF), U3.4 (VREF); also elsewhere on the board
/Motors/M1A: TP13.1 (1_1), U2.6 (OUT1)
/Motors/M1B: TP14.1 (1_1), U2.8 (OUT2)
/Motors/M2A: TP15.1 (1_1), U3.6 (OUT1)
/Motors/M2B: TP16.1 (1_1), U3.8 (OUT2)
GND: C30.2, C31.2, C32.2, C33.2, R13.2, R14.2, U2.7 (GND), U2.9 (GND), U3.7 (GND), U3.9 (GND); also elsewhere on the board
MA_IN1: U2.3 (IN1); also elsewhere on the board
MA_IN2: U2.2 (IN2); also elsewhere on the board
MA_IPROPI: R13.1, U2.1 (IPROPI); also elsewhere on the board
MB_IN1: U3.3 (IN1); also elsewhere on the board
MB_IN2: U3.2 (IN2); also elsewhere on the board
MB_IPROPI: R14.1, U3.1 (IPROPI); also elsewhere on the board
VBAT: C30.1, C31.1, C32.1, C33.1, U2.5 (VM), U3.5 (VM); also elsewhere on the board

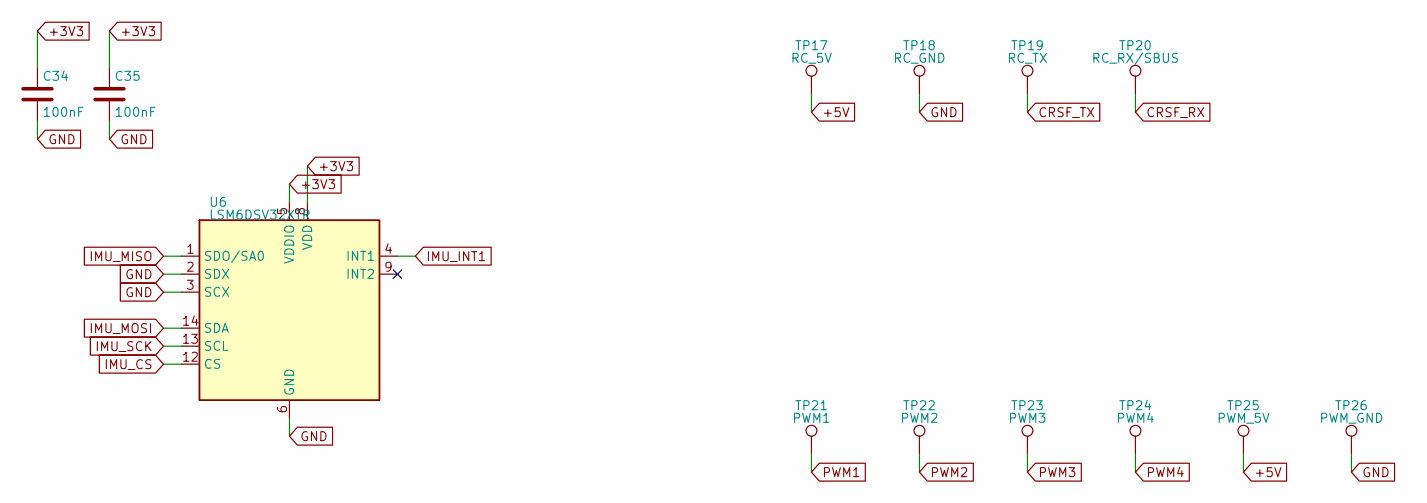
[picture p14: schematic io.kicad_sch]

Parts:
C34, C35: 100nF; C_0402_1005Metric; MPN CL05B104KO5NNNC; LCSC C1525
TP17: RC_5V; TestPoint_Pad_1.0x1.0mm
TP18: RC_GND; TestPoint_Pad_1.0x1.0mm
TP19: RC_TX; TestPoint_Pad_1.0x1.0mm
TP20: RC_RX/SBUS; TestPoint_Pad_1.0x1.0mm
TP21: PWM1; TestPoint_Pad_1.0x1.0mm
TP22: PWM2; TestPoint_Pad_1.0x1.0mm
TP23: PWM3; TestPoint_Pad_1.0x1.0mm
TP24: PWM4; TestPoint_Pad_1.0x1.0mm
TP25: PWM_5V; TestPoint_Pad_1.0x1.0mm
TP26: PWM_GND; TestPoint_Pad_1.0x1.0mm
U6: LSM6DSV32XTR; LGA-14_3x2.5mm_P0.5mm_CircuitNinja; MPN LSM6DSV32XTR; LCSC C22461202

Connections:
+3V3: C34.1, C35.1, U6.5 (VDDIO), U6.8 (VDD); also elsewhere on the board
+5V: TP17.1 (1_1), TP25.1 (1_1); also elsewhere on the board
CRSF_RX: TP20.1 (1_1); also elsewhere on the board
CRSF_TX: TP19.1 (1_1); also elsewhere on the board
GND: C34.2, C35.2, TP18.1 (1_1), TP26.1 (1_1), U6.2 (SDX), U6.3 (SCX), U6.6 (GND), U6.7 (GND); also elsewhere on the board
IMU_CS: U6.12 (CS); also elsewhere on the board
IMU_INT1: U6.4 (INT1); also elsewhere on the board
IMU_MISO: U6.1 (SDO/SA0); also elsewhere on the board
IMU_MOSI: U6.14 (SDA); also elsewhere on the board
IMU_SCK: U6.13 (SCL); also elsewhere on the board
PWM1: TP21.1 (1_1); also elsewhere on the board
PWM2: TP22.1 (1_1); also elsewhere on the board
PWM3: TP23.1 (1_1); also elsewhere on the board
PWM4: TP24.1 (1_1); also elsewhere on the board

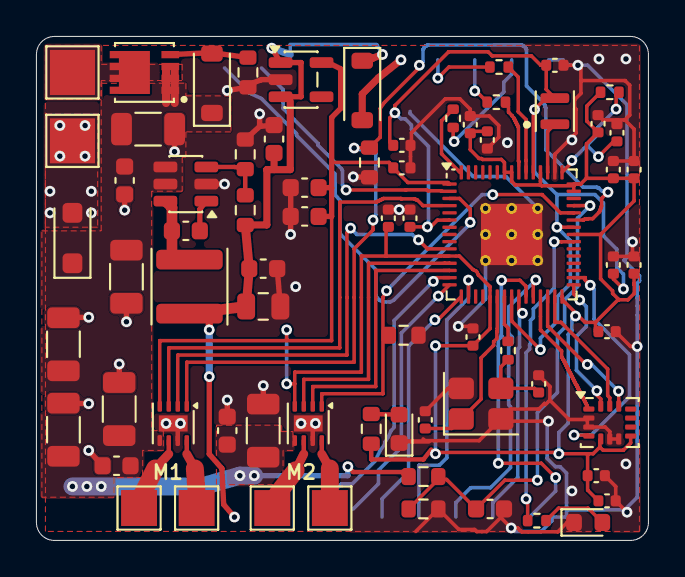
[picture p15: board hyperion.kicad_pcb from above]

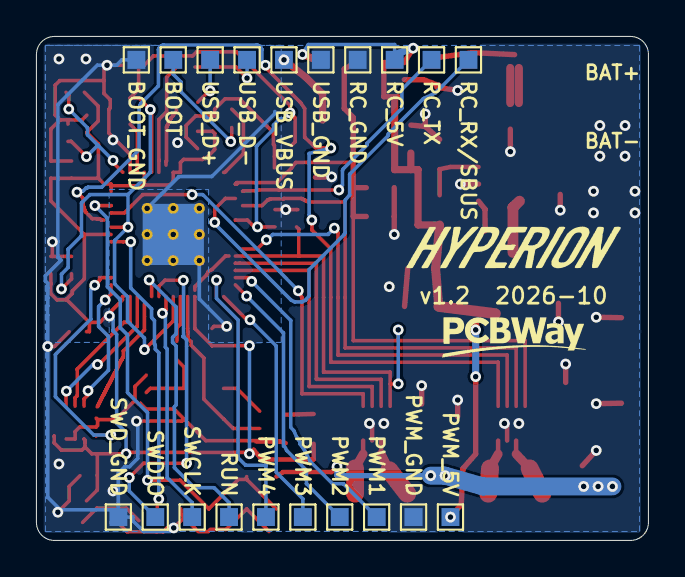
[picture p16: board hyperion.kicad_pcb from below]

Board: 2 copper layers, 34.0 x 28.0 mm, 90 parts (20 on the bottom side), 50 nets.
