adamhrnciar/hyperion-controller/firmware/src/bringup.h

// SPDX-License-Identifier: GPL-3.0-or-later
// Bring-up test modes (see firmware/BRINGUP.md). Each one never returns.

#pragma once

void mode_blink(void);
void mode_adc(void);
void mode_rc(void);
void mode_imu(void);
void mode_motor(void);
void mode_thermal(void);
