adamhrnciar/hyperion-controller/(commit log)

2026-10-29 Hyperion v1.2: KiCad project, fab files, schematic PDF
    [hyperion-v1.2-bom.csv, hyperion.kicad_pcb, hyperion.kicad_sch, io.kicad_sch, mcu.kicad_sch, motors.kicad_sch, power.kicad_sch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]
2026-11-01 WIP snapshot from zlaticko 2026-11-01
    [hyperion-v1.2-bom.csv, hyperion-v1.2-pcbway-bom.csv, hyperion-v1.2-pcbway-centroid.csv, hyperion.kicad_pcb, motors.kicad_sch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]
2026-11-13 fix(firmware): keep lost receiver input stale across timer rollover
    [rc_input.c, rc_pwm.c]
2026-11-13 docs(hardware): record v1.2 release blockers and preserve reviewed fab files
    [hyperion.kicad_pcb, pcb-positions.csv, schematic-bom.csv]
